rumpelrausch/showerMeter/docs/assets/img/OLED.png

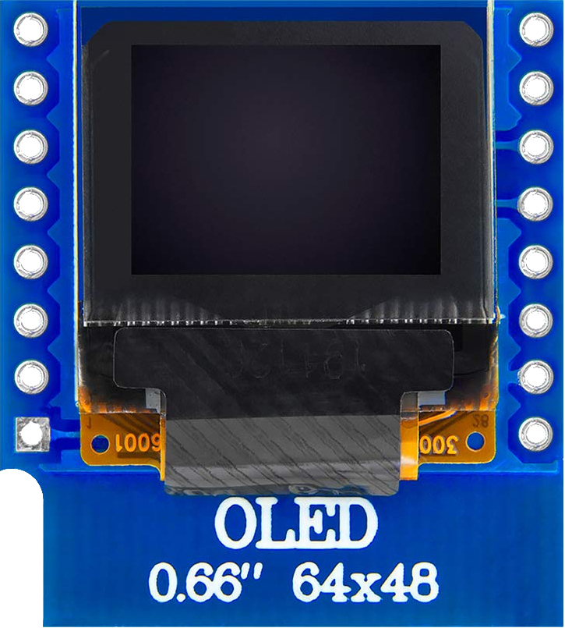
docs/assets/img/OLED.png
