rumpelrausch/showerMeter/(commit log)

2023-11-11 fix: did detect power on wrongly
    [showerMeter.ino]
2023-11-13 fix: does not reset while busy
    [showerMeter.ino]
2023-11-13 refactor: enhances timer overhead/precision (sets timer to 1/10th second)
2023-11-15 fix: shows correct cents with values >= 100
    [showerMeter.ino]
2023-11-15 fix: does not crash during blink
    [showerMeter.ino]
2023-11-15 fix: actually blinks ;-)
    [showerMeter.ino]
2023-11-15 feat: corrects function pointers, documents oversampling
    [showerMeter.ino]
2023-11-15 fix: corrects broken timer handling
    [showerMeter.ino]
